mertmihci/Micro-Air-Conditioner/README.md

# Micro-Air-Conditioner
This repository contains the LTspice design files and a laboratory report PDF for a project on analog electronics, specifically focusing on the design of a micro-air conditioner system.

LTspice Design:
The LTspice design files (.asc) are provided to showcase the simulation and analysis of the micro-air conditioner system. These files demonstrate the circuit implementation, component selection, and performance evaluation using LTspice simulation software.

Laboratory Report PDF:
The laboratory report PDF presents a comprehensive overview of the project, including the design methodology, circuit implementation details, simulation results, and experimental findings. This report follows IEEE format guidelines and provides insights into the design process, challenges encountered, and solutions employed.

Contents:

LTspice Designs/: This directory contains the LTspice design files (.asc) for the micro-air conditioner system.
Lab Report.pdf: This PDF document comprises the laboratory report detailing the project's objectives, methodology, results, and conclusions.
Usage:

Navigate to the LTspice_Designs/ directory to access the LTspice design files.
Open the desired LTspice design file (.asc) using LTspice software to simulate and analyze the micro-air conditioner system.
Refer to the Lab_Report.pdf document for a detailed overview of the project, including design specifications, circuit diagrams, simulation results, and experimental analysis.
Contributing:

Contributions to improve the LTspice designs or enhance the laboratory report content are welcome. Please fork the repository, make your changes, and submit a pull request for review.
Issues:

If you encounter any issues or have suggestions for improvement, please open an issue on the repository's GitHub page.
License:

This repository is licensed under the MIT License, allowing for open collaboration and sharing of the project content.
Acknowledgments:

We acknowledge the support and guidance received from our mentors and colleagues throughout the development of this project.
Contact:

For inquiries or further information, please contact [author_name] at [email_address].
Enjoy exploring the LTspice designs and laboratory report!
