mertmihci/Micro-Air-Conditioner/micro_air_conditioner.asc

0: res; 0
1k: res; 1k
BLUE: LED
Cooler: res; 10
GREEN: LED
Heater: res; 6.8
M1: nmos; IRFZ44N
M2: nmos; IRFZ44N
R1: res; 75k
R2: res; 1k
R3: res; 39k
R4: res; 1k
R5: res; 1k
R6: res; 1k
R7: res; 1k
R8: res; 120k
R9: res; 330k
R10: res; 1k
R11: res; 1k
R12: res; 1k
R13: res; 12k
R14: res; 12k
R15: res; 560
R17: res; 1k
R18: res; 12k
R19: res; 12k
R20: res; 560
R21: res; 560
R38: res; 1k
R39: res; 1k
R40: res; 1k
R41: res; 1k
R42: res; 1k
R43: res; 1k
RED: LED
U1: opamp2; LM741
U2: opamp2; LM741
U3: opamp2; LM741
U4: opamp2; LM741
U5: opamp2; LM741
U7: opamp2; LM741
U8: opamp2; LM741
U9: opamp2; LM741
U14: opamp2; LM741
U15: opamp2; LM741
V1: voltage; 5m
V2: voltage; -5m
V_6V: voltage; 6
V_in: voltage; 0
V_sen: voltage; 2.7
Vcc: voltage; 12
Vee: voltage; -12
Named nets: 0, Vcc, Vee, V_sens, V_6V, V_Set, V_ref, V_in
.lib LM741.sub
.dc V_in 2 4.5 0.1
Cooler
Heater
BLUE LED
RED LED
GREEN LED
Reference Voltage
SET UNIT
CONTROL UNIT
DISPLAY UNIT
SENSING UNIT
OPERATION UNIT
